IvyBit/ucnc/doc/header.png

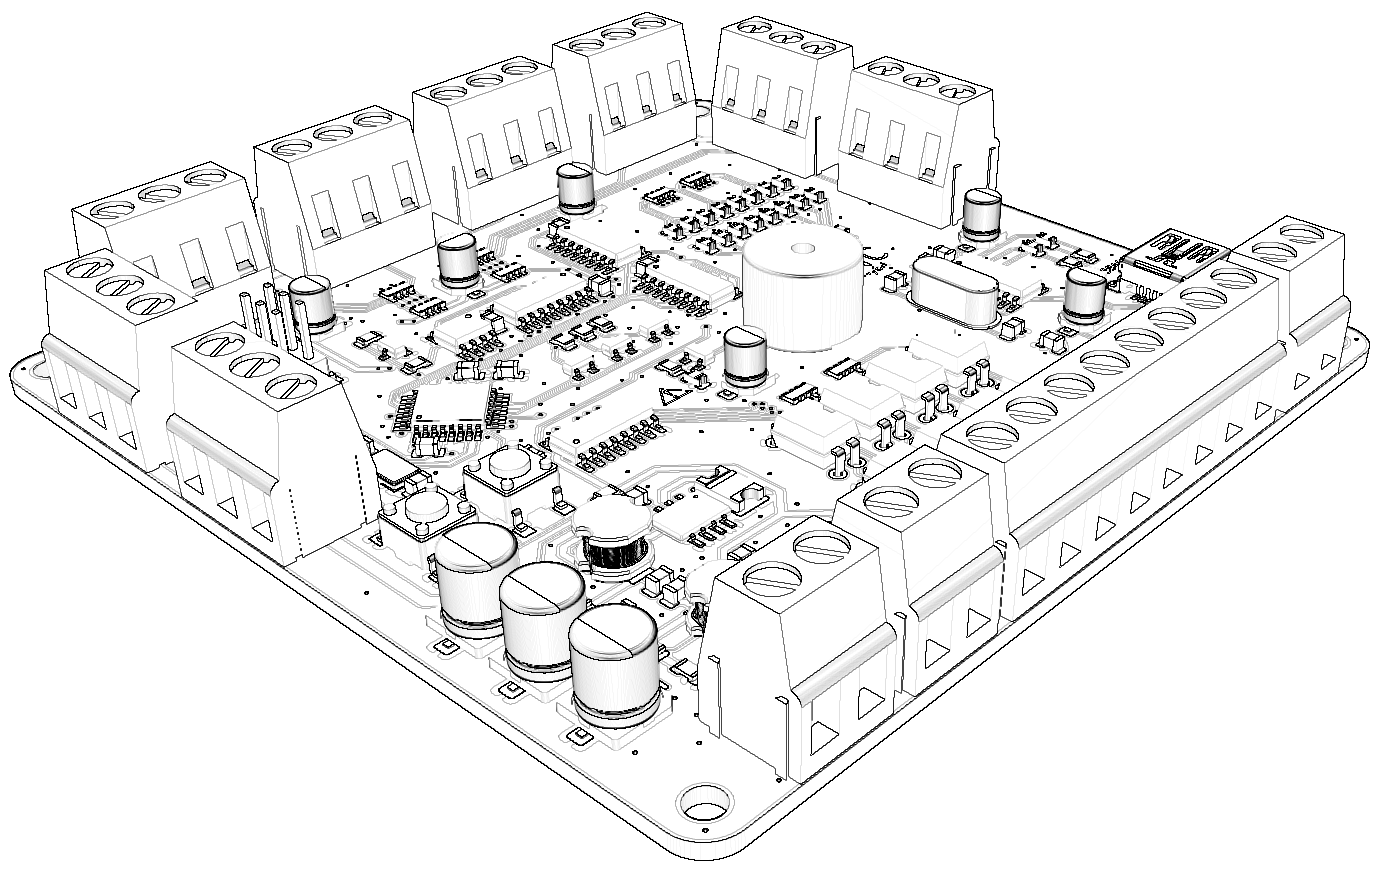
doc/header.png
