IvyBit/ucnc/doc/placeholder.png

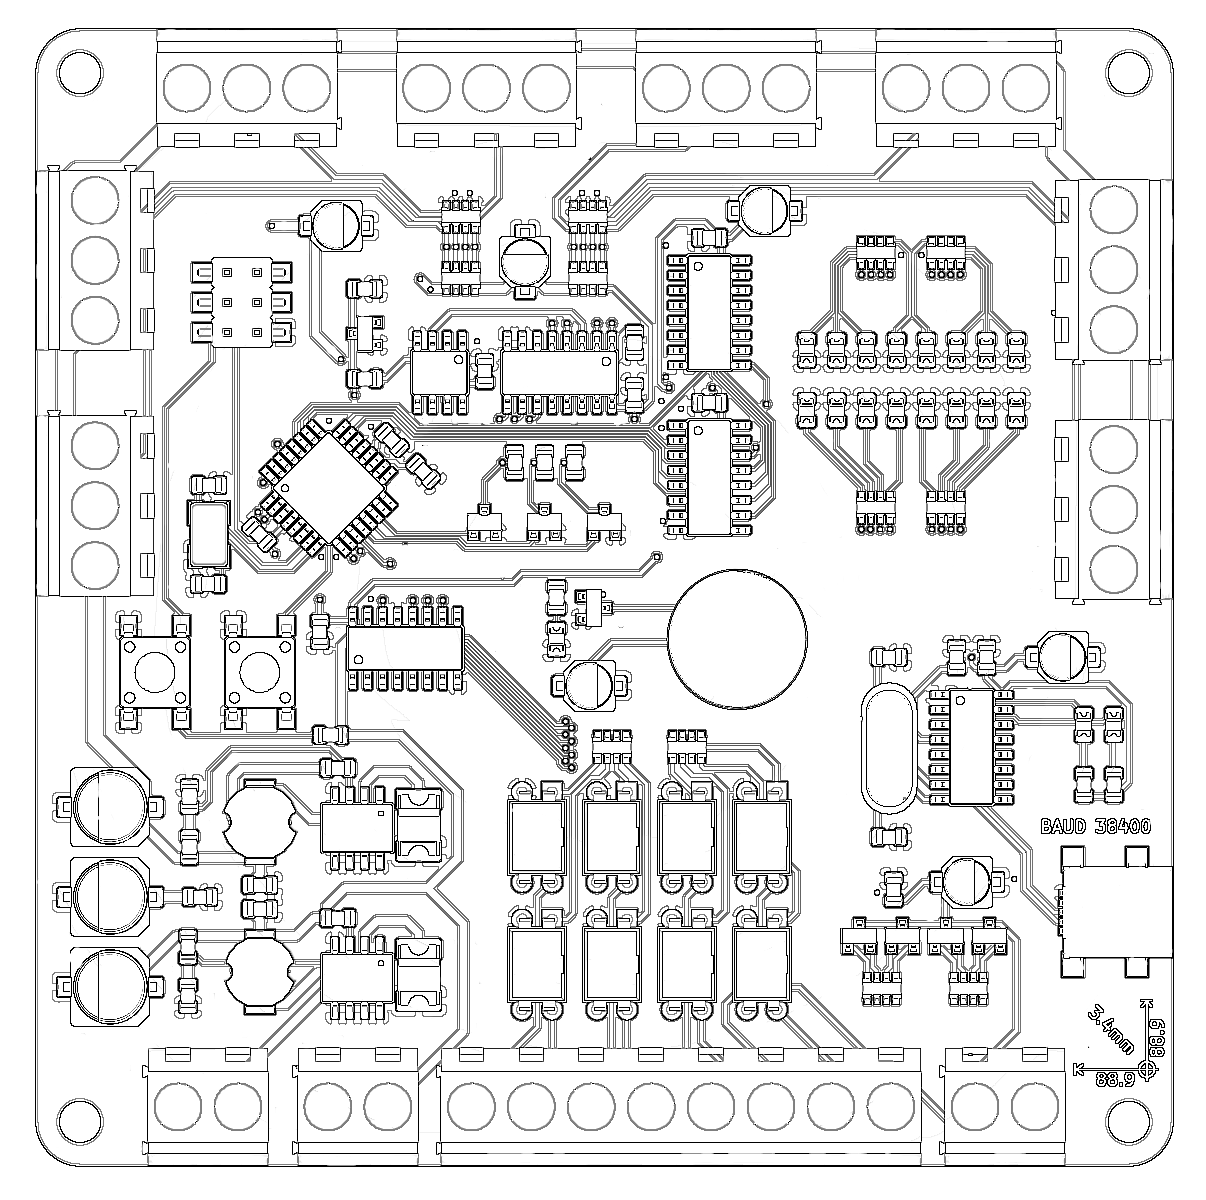
doc/placeholder.png
