IvyBit/ucnc/doc/sensors.png

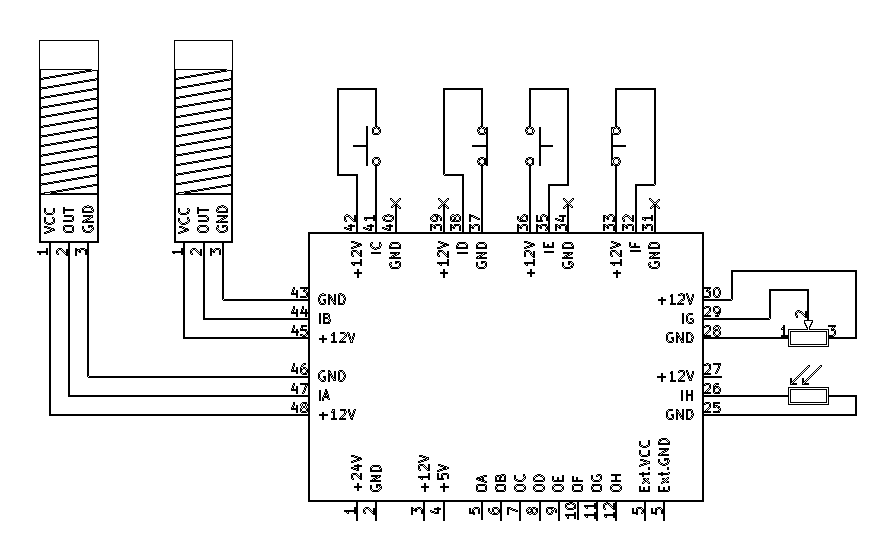
doc/sensors.png
