IvyBit/ucnc/bom.xlsx

Column1 | Column2 | Column3 | Column4
Comment | Designator | Footprint | LCSC
Buzzer | BZ1 | Buzzer_Beeper:Buzzer_15x7.5RM7.6 | C128017
22pF | C1,C2,C11,C12 | Capacitor_SMD:C_0805_2012Metric | C1804
100nF | C4,C5,C9,C10,C13,C16,C17,C18,C19,C20,C21,C23,C29 | Capacitor_SMD:C_0805_2012Metric | C49678
10uF | C8,C14,C15,C22,C24,C25,C26,C27,C28 | Capacitor_SMD:C_1206_3216Metric | C13585
470uF | C3 | Capacitor_SMD:CP_Elec_10x10 | C3350
220uF | C6,C7 | Capacitor_SMD:CP_Elec_6.3x7.7 | C3342
LEDO | D1,D2,D3,D4,D5,D6,D7,D8,D19,D27 | Diode_SMD:D_0805_2012Metric | C205444
BZX84C 5V1 | D17 | Diode_SMD:D_SOT-23_ANK | C294621
SS36-E3/57T | D20,D21 | Diode_SMD:D_2114_3652Metric | C35722
BAT54A | D23,D24,D25,D26 | Package_TO_SOT_SMD:SOT-23 | C556167
LEDB | D9,D10,D11,D12,D13,D14,D15,D16,D18,D22 | Diode_SMD:D_0805_2012Metric | C205441
3PT | J1,J2,J3,J4,J5,J6,J7,J8 | TerminalBlock_RND:TerminalBlock_RND_205-00013_1x03_P5.00mm_Horizontal | C8270
USB_B_Mini | J12 | Connector_USB:USB_Mini-B_Lumberg_2486_01_Horizontal | C1121886
2PT | J10,J13,J14,J15,J16,J17,J18 | TerminalBlock_RND:TerminalBlock_RND_205-00001_1x02_P5.00mm_Horizontal | C8404
AVR-ISP-6 | J9 | Connector_PinHeader_2.54mm:PinHeader_2x03_P2.54mm_Vertical_SMD | C192301
68uH | L1,L2 | Inductor_SMD:L_12x12mm_H8mm | C169377
2N7002 | Q1,Q2,Q3,Q4,Q5,Q6,Q7,Q8,Q9,Q11,Q12,Q13 | Package_TO_SOT_SMD:SOT-23 | C8545
220 | R1,R2,R3,R4,R5,R6,R7,R8 | Resistor_SMD:R_0805_2012Metric | C17557
10K | R17,R34,R68,R69,R70,R71 | Resistor_SMD:R_0805_2012Metric | C17724
6.8K | R35 | Resistor_SMD:R_0805_2012Metric | C17772
1K | R9,R60 | Resistor_SMD:R_0805_2012Metric | C17513
2K | R66,R67 | Resistor_SMD:R_0805_2012Metric | C17604
4.7KP4 | RN1,RN2,RN7,RN8,RN9,RN10 | Resistor_SMD:R_Array_Convex_4x0603 | C66697
330P4 | RN3,RN4 | Resistor_SMD:R_Array_Convex_4x0603 | C12018
620P4 | RN5,RN6 | Resistor_SMD:R_Array_Convex_4x0603 | C12034
RESET | SW1 | Button_Switch_SMD:SW_SPST_TL3342 | C318884
BTN | SW2 | Button_Switch_SMD:SW_SPST_TL3342 | C318884
GND | TP1 | TestPoint:TestPoint_Pad_D1.5mm
+24V | TP2 | TestPoint:TestPoint_Pad_D1.5mm
+5V | TP3 | TestPoint:TestPoint_Pad_D1.5mm
+12V | TP4 | TestPoint:TestPoint_Pad_D1.5mm
ATmega328PB-AU | U1 | Package_QFP:TQFP-32_7x7mm_P0.8mm | C132230
CH340G | U18 | Package_SO:SOIC-16_3.9x9.9mm_P1.27mm | C14267
XL1509-5E1 | U19 | Package_SO:SOIC-8_3.9x4.9mm_P1.27mm | C61063
74HC595 | U2,U3,U4 | Package_SO:SOIC-16_3.9x9.9mm_P1.27mm | C5947
4051 | U5 | Package_SO:SOIC-16_3.9x9.9mm_P1.27mm | C21379
XL1509-12E1 | U6 | Package_SO:SOIC-8_3.9x4.9mm_P1.27mm | C62594
ADuM1201AR | U7 | Package_SO:SOIC-8_3.9x4.9mm_P1.27mm | C9669
SGMOP07CXS8G/TR | U8 | Package_SO:SOIC-8_3.9x4.9mm_P1.27mm | C89712
EL357NC | U9,U10,U11,U12,U13,U14,U15,U16 | IvyBit-footprints:SOP-4_4.1x4.4x2.54P | C29981
16MHz | Y1 | Crystal:Crystal_SMD_3225-4Pin_3.2x2.5mm | C13738
12MHz | Y2 | Crystal:Crystal_SMD_3225-4Pin_3.2x2.5mm | C9002
