IvyBit/ucnc/cnc-universal-input.kicad_pcb

## KiCad design cnc-universal-input.kicad_pcb (2022-01-16)

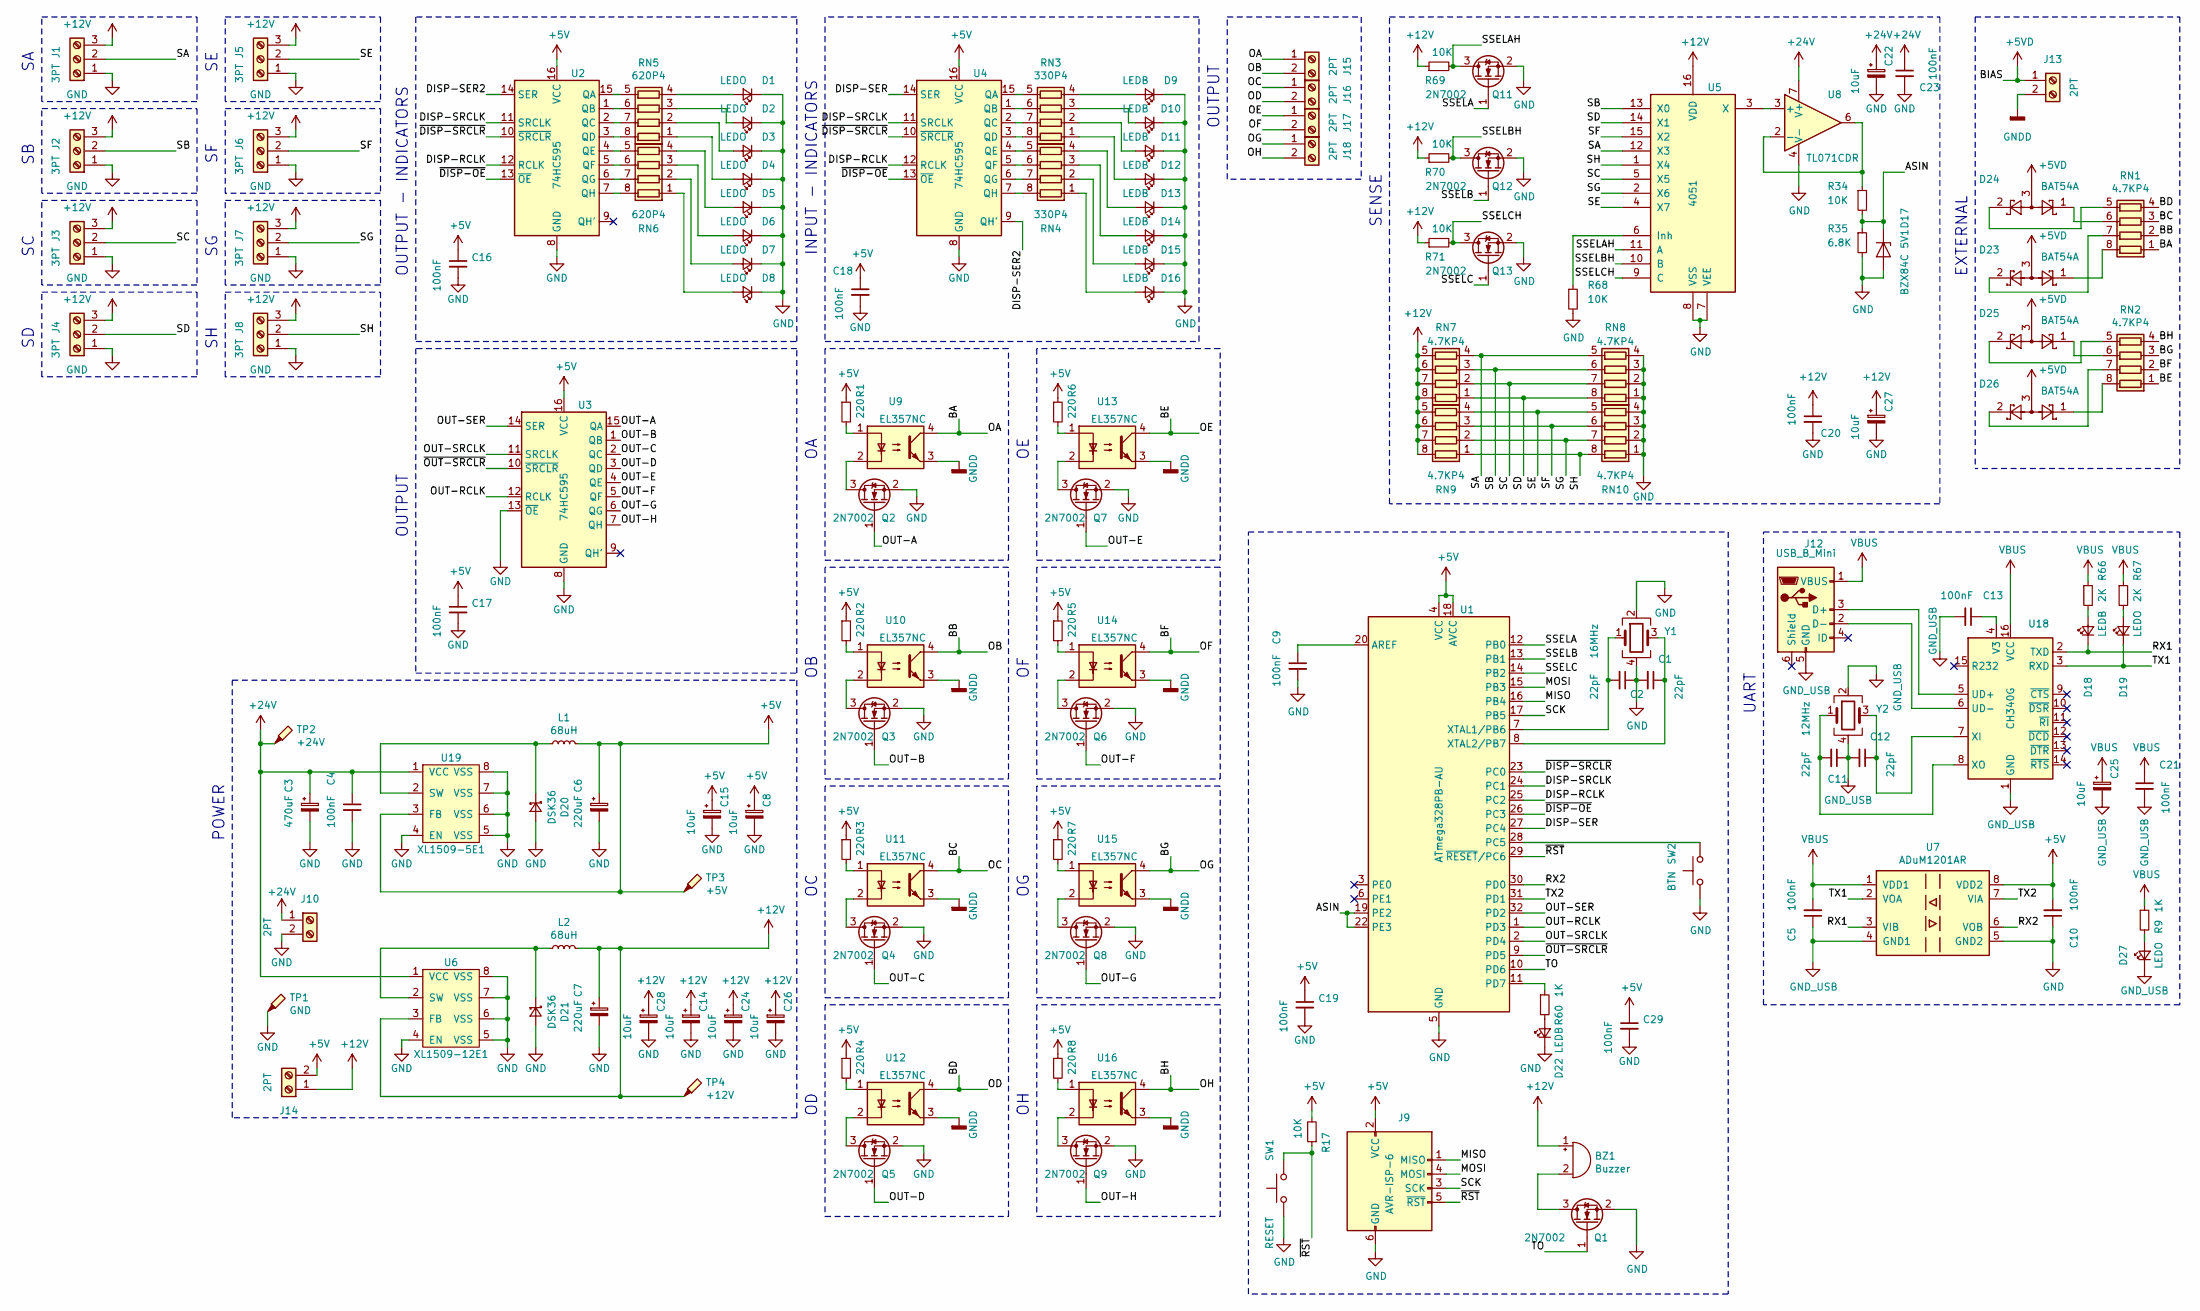
[picture p25: schematic cnc-universal-input.sch, UCNC]

Parts:
BZ1: Buzzer; Buzzer_15x7.5RM7.6; LCSC C128017
C1, C2, C11, C12: 22pF; C_0805_2012Metric; LCSC C1804
C3: 470uF; CP_Elec_10x10; LCSC C3350
C4, C5, C9, C10, C13, C16, C17, C18, C19, C20, C21, C23, C29: 100nF; C_0805_2012Metric; LCSC C49678
C6, C7: 220uF; CP_Elec_6.3x7.7; LCSC C3342
C8, C14, C15, C22, C24, C25, C26, C27, C28: 10uF; C_1206_3216Metric; LCSC C13585
D1, D2, D3, D4, D5, D6, D7, D8, D19, D27: LEDO; D_0805_2012Metric; LCSC C205444
D9, D10, D11, D12, D13, D14, D15, D16, D18, D22: LEDB; D_0805_2012Metric; LCSC C205441
D17: BZX84C 5V1; D_SOT-23_ANK; LCSC C294621
D20, D21: DSK36; D_SOD-123F; LCSC C106913
D23, D24, D25, D26: BAT54A; SOT-23; LCSC C556167
J1, J2, J3, J4, J5, J6, J7, J8: 3PT; TerminalBlock_RND_205-00013_1x03_P5.00mm_Horizontal; LCSC C8270
J9: AVR-ISP-6; PinHeader_2x03_P2.54mm_Vertical_SMD; LCSC C192301
J10, J13, J14, J15, J16, J17, J18: 2PT; TerminalBlock_RND_205-00001_1x02_P5.00mm_Horizontal; LCSC C8404
J12: USB_B_Mini; USB_Mini-B_Lumberg_2486_01_Horizontal; LCSC C1121886
L1, L2: 68uH; L_12x12mm_H8mm; LCSC C169377
Q1, Q2, Q3, Q4, Q5, Q6, Q7, Q8, Q9, Q11, Q12, Q13: 2N7002; SOT-23; LCSC C8545
R1, R2, R3, R4, R5, R6, R7, R8: 220; R_0805_2012Metric; LCSC C17557
R9, R60: 1K; R_0805_2012Metric; LCSC C17513
R17, R34, R68, R69, R70, R71: 10K; R_0805_2012Metric; LCSC C17724
R35: 6.8K; R_0805_2012Metric; LCSC C17772
R66, R67: 2K; R_0805_2012Metric; LCSC C17604
RN1, RN2, RN7, RN8, RN9, RN10: 4.7KP4; R_Array_Convex_4x0603; LCSC C66697
RN3, RN4: 330P4; R_Array_Convex_4x0603; LCSC C12018
RN5, RN6: 620P4; R_Array_Convex_4x0603; LCSC C12034
SW1: RESET; SW_SPST_TL3342; LCSC C318884
SW2: BTN; SW_SPST_TL3342; LCSC C318884
TP1: GND; TestPoint_Pad_D1.5mm
TP2: +24V; TestPoint_Pad_D1.5mm
TP3: +5V; TestPoint_Pad_D1.5mm
TP4: +12V; TestPoint_Pad_D1.5mm
U1: ATmega328PB-AU; TQFP-32_7x7mm_P0.8mm; LCSC C132230
U2, U3, U4: 74HC595; SOIC-16_3.9x9.9mm_P1.27mm; LCSC C5947
U5: 4051; SOIC-16_3.9x9.9mm_P1.27mm; LCSC C21379
U6: XL1509-12E1; SOIC-8_3.9x4.9mm_P1.27mm; LCSC C62594
U7: ADuM1201AR; SOIC-8_3.9x4.9mm_P1.27mm; LCSC C9669
U8: TL071CDR; SOIC-8_3.9x4.9mm_P1.27mm; LCSC C14449
U9, U10, U11, U12, U13, U14, U15, U16: EL357NC; SO-4_4.4x3.9mm_P2.54mm; LCSC C29981
U18: CH340G; SOIC-16_3.9x9.9mm_P1.27mm; LCSC C14267
U19: XL1509-5E1; SOIC-8_3.9x4.9mm_P1.27mm; LCSC C61063
Y1: 16MHz; Crystal_SMD_3225-4Pin_3.2x2.5mm; LCSC C13738
Y2: 12MHz; Crystal_SMD_3225-4Pin_3.2x2.5mm; LCSC C9002

Connections:
+5V: C6.1, C8.1, C10.2, C15.1, C16.1, C17.1, C18.1, C19.1, C29.1, J9.2 (VCC), J14.2, L1.2, R1.1, R2.1, R3.1, R4.1, R5.1, R6.1, R7.1, R8.1, R17.2, TP3.1, U1.4 (VCC), U1.18 (AVCC), U2.16 (VCC), U3.16 (VCC), U4.16 (VCC), U7.8 (VDD2), U19.3 (FB)
+5VD: D23.3, D24.3, D25.3, D26.3, J13.1
+12V: BZ1.1 (-), C7.1, C14.1, C20.1, C24.1, C26.1, C27.1, C28.1, J1.3, J2.3, J3.3, J4.3, J5.3, J6.3, J7.3, J8.3, J14.1, L2.2, R69.1, R70.1, R71.1, RN7.5 (R4.2), RN7.6 (R3.2), RN7.7 (R2.2), RN7.8 (R1.2), RN9.5 (R4.2), RN9.6 (R3.2), RN9.7 (R2.2), RN9.8 (R1.2), TP4.1, U5.16 (VDD), U6.3 (FB)
+24V: C3.1, C4.1, C22.1, C23.1, J10.1, TP2.1, U6.1 (VCC), U8.7 (V+), U19.1 (VCC)
/ASIN: D17.1 (K), R34.2, R35.1, U1.19 (PE2), U1.22 (PE3)
/BA: J15.1, RN1.1 (R1.1), U9.4
/BB: J15.2, RN1.2 (R2.1), U10.4
/BC: J16.1, RN1.3 (R3.1), U11.4
/BD: J16.2, RN1.4 (R4.1), U12.4
/BE: J17.1, RN2.1 (R1.1), U13.4
/BF: J17.2, RN2.2 (R2.1), U14.4
/BG: J18.1, RN2.3 (R3.1), U15.4
/BH: J18.2, RN2.4 (R4.1), U16.4
/DISP-RCLK: U1.25 (PC2), U2.12 (RCLK), U4.12 (RCLK)
/DISP-SER: U1.27 (PC4), U4.14 (SER)
/DISP-SER2: U2.14 (SER), U4.9 (QH')
/DISP-SRCLK: U1.24 (PC1), U2.11 (SRCLK), U4.11 (SRCLK)
/MISO: J9.1 (MISO), U1.16 (PB4)
/MOSI: J9.4 (MOSI), U1.15 (PB3)
/OUT-A: Q2.1 (G), U3.15 (QA)
/OUT-B: Q3.1 (G), U3.1 (QB)
/OUT-C: Q4.1 (G), U3.2 (QC)
/OUT-D: Q5.1 (G), U3.3 (QD)
/OUT-E: Q7.1 (G), U3.4 (QE)
/OUT-F: Q6.1 (G), U3.5 (QF)
/OUT-G: Q8.1 (G), U3.6 (QG)
/OUT-H: Q9.1 (G), U3.7 (QH)
/OUT-RCLK: U1.1 (PD3), U3.12 (RCLK)
/OUT-SER: U1.32 (PD2), U3.14 (SER)
/OUT-SRCLK: U1.2 (PD4), U3.11 (SRCLK)
/RX1: D18.1 (K), U7.3 (VIB), U18.2 (TXD)
/RX2: U1.30 (PD0), U7.6 (VOB)
/SA: J1.2, RN7.4 (R4.1), RN8.5 (R4.2), U5.12 (X3)
/SB: J2.2, RN7.3 (R3.1), RN8.6 (R3.2), U5.13 (X0)
/SC: J3.2, RN7.2 (R2.1), RN8.7 (R2.2), U5.5 (X5)
/SCK: J9.3 (SCK), U1.17 (PB5)
/SD: J4.2, RN7.1 (R1.1), RN8.8 (R1.2), U5.14 (X1)
/SE: J5.2, RN9.4 (R4.1), RN10.5 (R4.2), U5.4 (X7)
/SF: J6.2, RN9.3 (R3.1), RN10.6 (R3.2), U5.15 (X2)
/SG: J7.2, RN9.2 (R2.1), RN10.7 (R2.2), U5.2 (X6)
/SH: J8.2, RN9.1 (R1.1), RN10.8 (R1.2), U5.1 (X4)
/SSELA: Q11.1 (G), U1.12 (PB0)
/SSELAH: Q11.3 (D), R69.2, U5.11 (A)
/SSELB: Q12.1 (G), U1.13 (PB1)
/SSELBH: Q12.3 (D), R70.2, U5.10 (B)
/SSELC: Q13.1 (G), U1.14 (PB2)
/SSELCH: Q13.3 (D), R71.2, U5.9 (C)
/TO: Q1.1 (G), U1.10 (PD6)
/TX1: D19.1 (K), U7.2 (VOA), U18.3 (RXD)
/TX2: U1.31 (PD1), U7.7 (VIA)
/~DISP-OE: U1.26 (PC3), U2.13 (~OE), U4.13 (~OE)
/~DISP-SRCLR: U1.23 (PC0), U2.10 (~SRCLR), U4.10 (~SRCLR)
/~OUT-SRCLR: U1.9 (PD5), U3.10 (~SRCLR)
/~RST: J9.5 (~RST), R17.1, SW1.2, U1.29 (~RESET~/PC6)
GND: C1.2, C2.1, C3.2, C4.2, C6.2, C7.2, C8.2, C9.2, C10.1, C14.2, C15.2, C16.2, C17.2, C18.2, C19.2, C20.2, C22.2, C23.2, C24.2, C26.2, C27.2, C28.2, C29.2, D1.1 (K), D2.1 (K), D3.1 (K), D4.1 (K), D5.1 (K), D6.1 (K), D7.1 (K), D8.1 (K), D9.1 (K), D10.1 (K), D11.1 (K), D12.1 (K), D13.1 (K), D14.1 (K), D15.1 (K), D16.1 (K), D17.2 (A), D20.2 (A), D21.2 (A), D22.1 (K), J1.1, J2.1, J3.1, J4.1, J5.1, J6.1, J7.1, J8.1, J9.6 (GND), J10.2, Q1.2 (S), Q2.2 (S), Q3.2 (S), Q4.2 (S), Q5.2 (S), Q6.2 (S), Q7.2 (S), Q8.2 (S), Q9.2 (S), Q11.2 (S), Q12.2 (S), Q13.2 (S), R35.2, R68.2, RN8.1 (R1.1), RN8.2 (R2.1), RN8.3 (R3.1), RN8.4 (R4.1), RN10.1 (R1.1), RN10.2 (R2.1), RN10.3 (R3.1), RN10.4 (R4.1), SW1.1, SW2.1, TP1.1, U1.5 (GND), U1.21 (GND), U2.8 (GND), U3.8 (GND), U3.13 (~OE), U4.8 (GND), U5.7 (VEE), U5.8 (VSS), U6.4 (EN), U6.5 (VSS), U6.6 (VSS), U6.7 (VSS), U6.8 (VSS), U7.5 (GND2), U8.4 (V-), U19.4 (EN), U19.5 (VSS), U19.6 (VSS), U19.7 (VSS), U19.8 (VSS), Y1.2, Y1.4
GNDD: J13.2, U9.3, U10.3, U11.3, U12.3, U13.3, U14.3, U15.3, U16.3
GND_USB: C5.1, C11.1, C12.2, C13.2, C21.2, C25.2, D27.1 (K), J12.5 (GND), U7.4 (GND1), U18.1 (GND), Y2.2, Y2.4
unnamed: BZ1.2 (+), Q1.3 (D)
unnamed: C1.1, U1.8 (XTAL2/PB7), Y1.3
unnamed: C2.2, U1.7 (XTAL1/PB6), Y1.1
unnamed: C9.1, U1.20 (AREF)
unnamed: C11.2, U18.8 (XO), Y2.1
unnamed: C12.1, U18.7 (XI), Y2.3
unnamed: C13.1, U18.4 (V3)
unnamed: D1.2 (A), RN5.4 (R4.1)
unnamed: D2.2 (A), RN5.3 (R3.1)
unnamed: D3.2 (A), RN5.2 (R2.1)
unnamed: D4.2 (A), RN5.1 (R1.1)
unnamed: D5.2 (A), RN6.4 (R4.1)
unnamed: D6.2 (A), RN6.3 (R3.1)
unnamed: D7.2 (A), RN6.2 (R2.1)
unnamed: D8.2 (A), RN6.1 (R1.1)
unnamed: D9.2 (A), RN3.4 (R4.1)
unnamed: D10.2 (A), RN3.3 (R3.1)
unnamed: D11.2 (A), RN3.2 (R2.1)
unnamed: D12.2 (A), RN3.1 (R1.1)
unnamed: D13.2 (A), RN4.4 (R4.1)
unnamed: D14.2 (A), RN4.3 (R3.1)
unnamed: D15.2 (A), RN4.2 (R2.1)
unnamed: D16.2 (A), RN4.1 (R1.1)
unnamed: D18.2 (A), R66.2
unnamed: D19.2 (A), R67.2
unnamed: D20.1 (K), L1.1, U19.2 (SW)
unnamed: D21.1 (K), L2.1, U6.2 (SW)
unnamed: D22.2 (A), R60.2
unnamed: D23.1, RN1.8 (R1.2)
unnamed: D23.2, RN1.7 (R2.2)
unnamed: D24.1, RN1.6 (R3.2)
unnamed: D24.2, RN1.5 (R4.2)
unnamed: D25.1, RN2.6 (R3.2)
unnamed: D25.2, RN2.5 (R4.2)
unnamed: D26.1, RN2.8 (R1.2)
unnamed: D26.2, RN2.7 (R2.2)
unnamed: D27.2 (A), R9.2
unnamed: J12.2 (D-), U18.6 (UD-)
unnamed: J12.3 (D+), U18.5 (UD+)
unnamed: Q2.3 (D), U9.2
unnamed: Q3.3 (D), U10.2
unnamed: Q4.3 (D), U11.2
unnamed: Q5.3 (D), U12.2
unnamed: Q6.3 (D), U14.2
unnamed: Q7.3 (D), U13.2
unnamed: Q8.3 (D), U15.2
unnamed: Q9.3 (D), U16.2
unnamed: R1.2, U9.1
unnamed: R2.2, U10.1
unnamed: R3.2, U11.1
unnamed: R4.2, U12.1
unnamed: R5.2, U14.1
unnamed: R6.2, U13.1
unnamed: R7.2, U15.1
unnamed: R8.2, U16.1
unnamed: R34.1, U8.2 (-), U8.6
unnamed: R60.1, U1.11 (PD7)
unnamed: R68.1, U5.6 (Inh)
unnamed: RN3.5 (R4.2), U4.15 (QA)
unnamed: RN3.6 (R3.2), U4.1 (QB)
unnamed: RN3.7 (R2.2), U4.2 (QC)
unnamed: RN3.8 (R1.2), U4.3 (QD)
unnamed: RN4.5 (R4.2), U4.4 (QE)
unnamed: RN4.6 (R3.2), U4.5 (QF)
unnamed: RN4.7 (R2.2), U4.6 (QG)
unnamed: RN4.8 (R1.2), U4.7 (QH)
unnamed: RN5.5 (R4.2), U2.15 (QA)
unnamed: RN5.6 (R3.2), U2.1 (QB)
unnamed: RN5.7 (R2.2), U2.2 (QC)
unnamed: RN5.8 (R1.2), U2.3 (QD)
unnamed: RN6.5 (R4.2), U2.4 (QE)
unnamed: RN6.6 (R3.2), U2.5 (QF)
unnamed: RN6.7 (R2.2), U2.6 (QG)
unnamed: RN6.8 (R1.2), U2.7 (QH)
unnamed: SW2.2, U1.28 (PC5)
unnamed: U5.3 (X), U8.3 (+)
VBUS: C5.2, C21.1, C25.1, J12.1 (VBUS), R9.1, R66.1, R67.1, U7.1 (VDD1), U18.16 (VCC)

Notes on the sheet:
POWER
INPUT - INDICATORS
OUTPUT - INDICATORS
SENSE
EXTERNAL
OUTPUT
UART

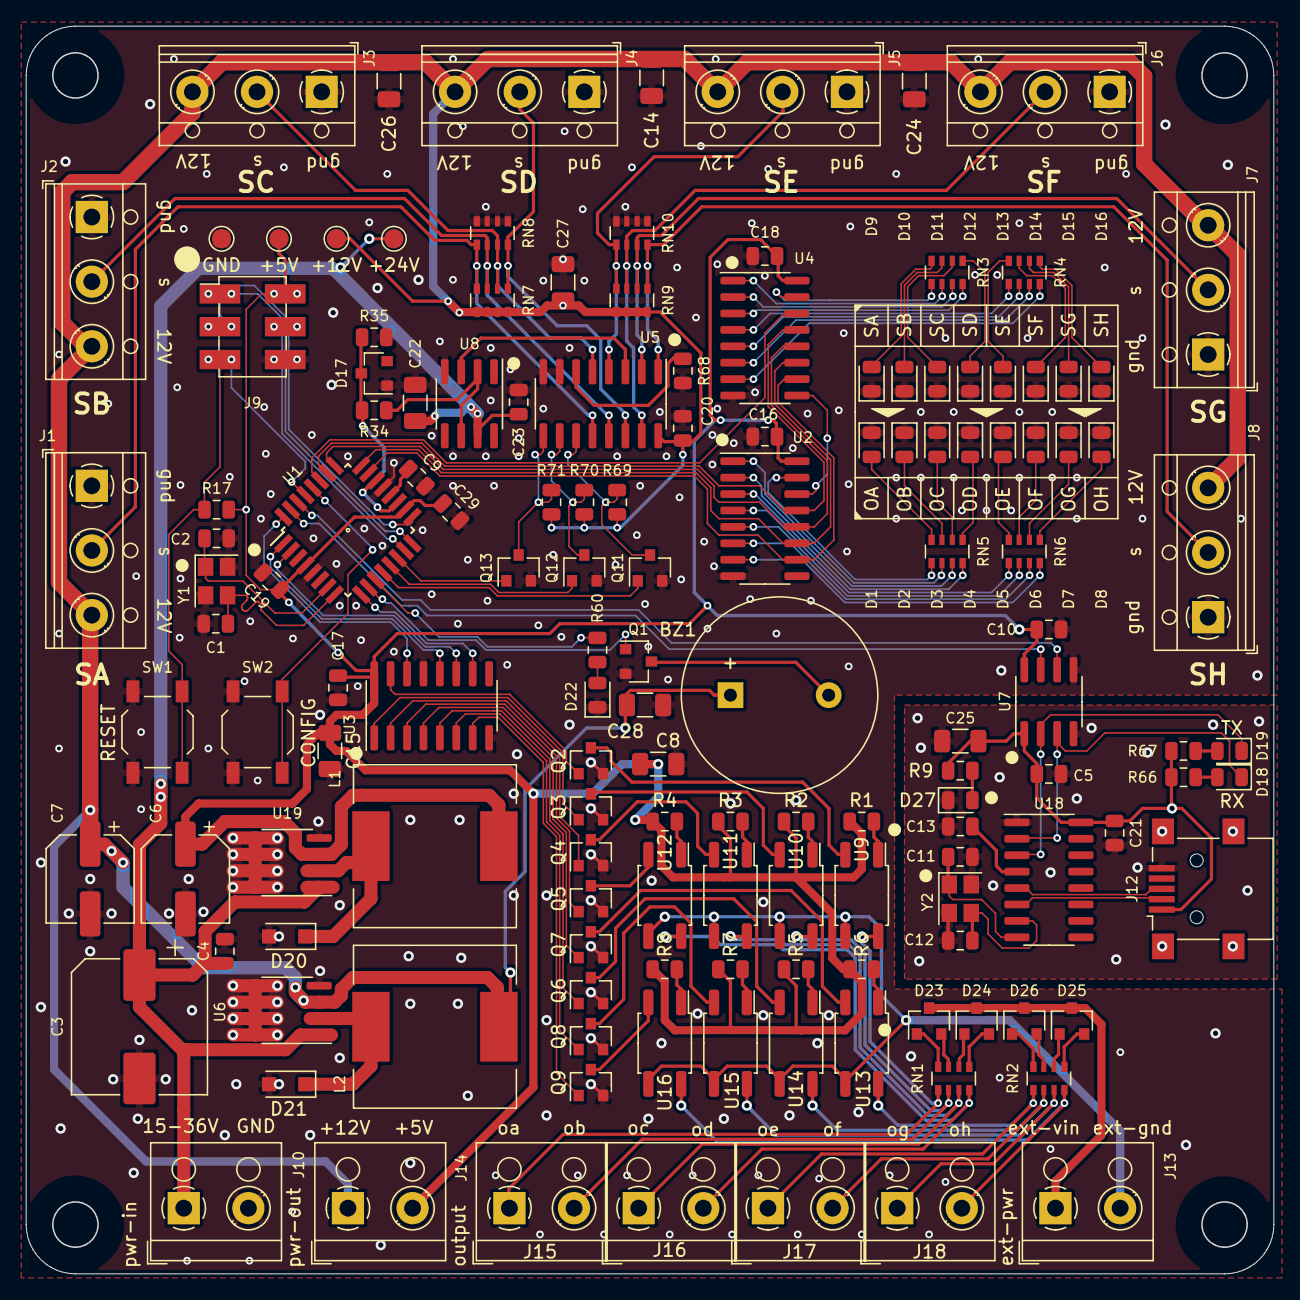
[picture p26: board cnc-universal-input.kicad_pcb from above]

Board: 2 copper layers, 96.5 x 96.5 mm, 143 parts (0 on the bottom side), 134 nets.
