IvyBit/ucnc/(commit log)

2021-01-17 4051s suck
    4051s exist as HC version... did you know that?
    [bom.xlsx, cnc-universal-input.kicad_pcb, cnc-universal-input.sch]
2021-01-18 Kicad is silly
    [cnc-universal-input.kicad_pcb, cnc-universal-input.sch]
2021-01-29 fixed analog read
    [cnc-universal-input.kicad_pcb]
2021-02-14 Stupid CH34G
    Stupid CH34G
    [cnc-universal-input.kicad_pcb, cnc-universal-input.sch]
2021-02-14 Revert "Stupid CH34G"
    This reverts commit 7f279e1c5784e09311cf2a8559607ba385112eda.
    [cnc-universal-input.kicad_pcb, cnc-universal-input.sch]
2021-02-14 Fixed 340G isolation issue
    [cnc-universal-input.kicad_pcb, cnc-universal-input.sch]
2021-02-16 switched to preallocated buffers
    Really doesn't matter for this project.. just a something that bugged me.
    [main.cpp]
2021-02-24 had to be quick
    Had to hack something together to get the cnc running again. I think simply "refactoring" won't do it, this needs some serious work.
    Parser works.
    Expression evaluation works.
    Truth table gets generated and outputs work.
    Saving and loading works.
    Live view works.
    Sorry had to be quick.
    [main.cpp]
2021-02-24 Changed the voltage divider
    Forgot to change R2 to 10K/7K so the input voltage to the adc was a bit low. 4.5 instead of 4.9.
    [cnc-universal-input.kicad_pcb, cnc-universal-input.sch]
2021-02-28 updated output config
    Output config now shows total mem free, exp mem, the expression itself and
    the error messages should be a bit more user friendly.
    [main.cpp]
2021-02-28 fixed issue with backspace, colors!
    Pretty colors and threshold in status screen.
    Had a fight with putty and lost...
    [main.cpp]
2021-04-09 crap!
    wrong foot print
    [cnc-universal-input.kicad_pcb, cnc-universal-input.sch]
2021-04-30 fixed labels
    [cnc-universal-input.kicad_pcb]
2021-05-08 Couldn't find a single 328PB non AU
    Atmega328PB-AU is the only 328 I could get...
    [cnc-universal-input.kicad_pcb, cnc-universal-input.sch]
2021-05-08 ups...
    Past me had the same Idea
    [cnc-universal-input.kicad_pcb]
2021-05-08 Changed Footprint
    5mm rm buzzers don't exist
    [cnc-universal-input.kicad_pcb, cnc-universal-input.sch]
2021-06-14 Yeetus deletus
    [cnc-universal-input.kicad_pcb, cnc-universal-input.sch]
2021-06-21 8bit adc go brrrrr
2021-07-08 Board stuff
    Flipped the input polarity
    [cnc-universal-input.kicad_pcb, cnc-universal-input.sch]
2021-07-13 ofc i missed one
    [cnc-universal-input.kicad_pcb]
2021-07-24 I am speed!
    Bumped the adc clock to 1Mhz and dropped down to 8 bit.
    [cnc-universal-input.kicad_pcb]
2021-08-12 bom be gone
    [bom.xlsx, cnc-universal-input.csv]
2021-08-13 Fixed missing and broken step files
    [cnc-universal-input.kicad_pcb, cnc-universal-input.sch]
2021-09-17 Cap be gone
    [cnc-universal-input.kicad_pcb, cnc-universal-input.sch]
2021-09-17 vias
    removed most vias under pads
    [cnc-universal-input.kicad_pcb]
2021-10-24 assemble all the things!
    JLCPCB please make my life easier!!
    [cnc-universal-input.kicad_pcb, cnc-universal-input.sch]
2021-11-26 Nothing! Absolutely Nothing!
    [cnc-universal-input.sch]
2022-01-16 Keep something in stock ffs...
    [bom.xlsx, cnc-universal-input.kicad_pcb, cnc-universal-input.sch]
2022-02-05 switched the 5ohm resistors with 10k ones... burn baby burn
    [cnc-universal-input.sch]
2022-02-05 wrong opamp...
    [cnc-universal-input.sch]
2022-02-05 We wait for no buzzers
    [cnc-universal-input.sch]
